OpenGammaProject/Enhanced-Geiger/Hardware/BOM.csv

ID | Name | Designator | Footprint | Quantity | Manufacturer Part | Manufacturer | Supplier | Supplier Part | Price
1 | SZYY1206YG | ACTIVITY | LED1206-R-RD_GREEN | 1 | SZYY1206YG | yongyu(永裕光电) | LCSC | C434442 | 0.016
2 | SMD-7525-3627-16Ω | BUZZER1 | BUZ-SMD_4P-L7.5-W7.5-BR | 1 | SMD-7525-3627-16Ω | S&S(海旭) | LCSC | C2685546 | 0.272
3 | 4.7uF | C1,C2,C7,C9,C11 | C0805 | 5 | CL21A475KBQNNNE | SAMSUNG(三星) | LCSC | C98192 | 0.023
4 | 10uF | C3,C5,C6,C8,C10 | C0603 | 5 | CL10A106MQ8NNNC | SAMSUNG(三星) | LCSC | C1691 | 0.002
5 | 100nF | C4 | C0603 | 1 | CL10B104KB8NNNC | SAMSUNG(三星) | LCSC | C1591 | 0.002
6 | 22pF | C12 | C0603 | 1 | GRM1882C1H220JA01D | muRata(村田) | LCSC | C85969 | 0.006
7 | BAT48ZFILM | D1,D2,D3 | SOD-123_L2.7-W1.6-LS3.7-RD-1 | 3 | BAT48ZFILM | ST(意法半导体) | LCSC | C2935154 | 0.108
8 | 0467.750NRHF | F1 | F0603 | 1 | 0467.750NRHF | Littelfuse(美国力特) | LCSC | C206991 | 0.048
9 | PH-2AW | H1,H3 | CONN-TH_PH-2AW | 2 | PH-2AW | CAX(创都) | LCSC | C722769 | 0.004
10 | TS-1103ST-C-B | KEY1 | KEY-SMD_4P-L12.0-W12.0-P5.00-LS15.1 | 1 | TS-1103ST-C-B | XKB Connectivity(中国星坤) | LCSC | C318913 | 0.051
11 | 22uH | L1 | IND-SMD_L3.0-W3.0_FNR30XXS | 1 | SLW3012S220MST | Sunltech(韩国顺磁) | LCSC | C206318 | 0.056
12 | 4.7uH | L2,L3 | L0603 | 2 | MLZ1608M4R7WT000 | TDK | LCSC | C76799 | 0.047
13 | DMG2305UX-13 | Q1 | SOT-23-3_L2.9-W1.3-P1.90-LS2.4-BR | 1 | DMG2305UX-13 | DIODES(美台) | LCSC | C144153 | 0.042
14 | 2N7002K_C414015 | Q2 | SOT-23-3_L2.9-W1.3-P1.90-LS2.4-BR | 1 | 2N7002K | MDD | LCSC | C414015 | 0.011
15 | 20kΩ | R1,R12 | RES-ADJ-TH_3362P | 2 | 3362P-1-203LF | BOURNS | LCSC | C81263 | 0.258
16 | 100Ω | R2,R5,R10,R16 | R0603 | 4 | 0603WAF1000T5E | UNI-ROYAL(厚声) | LCSC | C22775 | 0.001
17 | 1.8kΩ | R3,R6,R8,R11,R15,R20 | R0603 | 6 | RT0603DRD071K8L | YAGEO(国巨) | LCSC | C705955 | 0.013
18 | 499kΩ | R4,R7,R18,R21 | R0603 | 4 | TR0603B499KP0525Z | EVER OHMS(天二科技) | LCSC | C149937 | 0.015
19 | 10kΩ | R9 | R0603 | 1 | ARG03DTC1002 | Viking(光颉) | LCSC | C311889 | 0.007
20 | 22kΩ | R22 | R0603 | 1 | ARG03BTC2202 | Viking(光颉) | LCSC | C335085 | 0.024
21 | SK-3296S-01-L3 | SW1 | SW-SMD_SK-3296S-01-L3 | 1 | SK-3296S-01-L3 | XKB Connectivity(中国星坤) | LCSC | C319019 | 0.07
22 | TLV3201AIDBVR | U1 | SOT-23-5_L3.0-W1.7-P0.95-LS2.8-BR | 1 | TLV3201AIDBVR | TI(德州仪器) | LCSC | C105188 | 0.504
23 | LM4040AIM3-3.0+T | U2 | SOT-23-3_L2.9-W1.6-P1.90-LS2.8-BR | 1 | LM4040AIM3-3.0+T | ADI(亚德诺)/MAXIM(美信) | LCSC | C143326 | 1.087
24 | BQ21040DBVR | U3 | SOT-23-6_L2.9-W1.6-P0.95-LS2.8-BR | 1 | BQ21040DBVR | TI(德州仪器) | LCSC | C202311 | 0.336
25 | PI-PICO-SMD | U4 | RASPBERRY PICO SMD | 1 | PICO | Raspberry Pi | LCSC | C7203002 | 4.375
26 | AP3015KTR-G1 | U5 | SOT-23-5_L3.0-W1.7-P0.95-LS2.8-BR | 1 | AP3015KTR-G1 | DIODES(美台) | LCSC | C151334 | 0.22
