OpenGammaProject/Enhanced-Geiger/Hardware/schematic.pdf

# Pulse Discriminator

## Protected LiPo only!!!

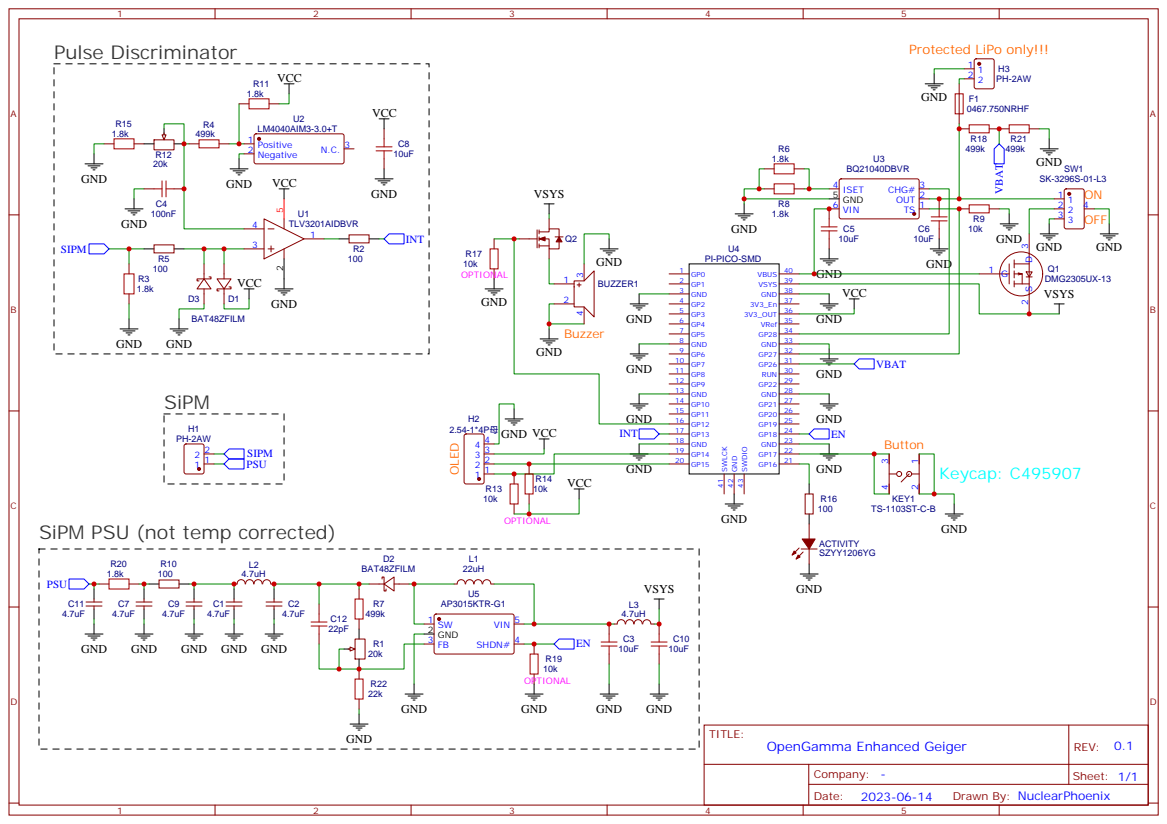
[picture p3: page 1]

SiPM PSU (not temp corrected)
