OpenGammaProject/Enhanced-Geiger/Software/enhanced_geiger/gfx.h

/*

  Contains graphics

*/

// Array of all bitmaps for convenience. (Total bytes used to store images in PROGMEM = 992)
// opengamma_pcb, 30 , 30 px
const uint8_t opengamma_pcb[] PROGMEM = {
  0x00, 0x00, 0x00, 0x00,
  0x00, 0x00, 0x00, 0x00,
  0x00, 0x03, 0x00, 0x00,
  0x00, 0x03, 0x00, 0x00,
  0x00, 0x07, 0x80, 0x00,
  0x00, 0x0c, 0xc0, 0x00,
  0x00, 0x0c, 0xc0, 0x00,
  0x00, 0x18, 0x60, 0x00,
  0x00, 0x18, 0x60, 0x00,
  0x00, 0x30, 0x30, 0x00,
  0x00, 0x30, 0x30, 0x00,
  0x00, 0x60, 0x18, 0x00,
  0x00, 0xc0, 0x0c, 0x00,
  0x00, 0xd8, 0x6c, 0x00,
  0x01, 0x9c, 0x66, 0x00,
  0x01, 0x84, 0x66, 0x00,
  0x03, 0x00, 0x43, 0x00,
  0x03, 0x02, 0x83, 0x00,
  0x06, 0x02, 0x81, 0x80,
  0x0c, 0x00, 0x00, 0xc0,
  0x0c, 0x01, 0x00, 0xc0,
  0x18, 0x01, 0x00, 0x60,
  0x18, 0x03, 0x00, 0x60,
  0x30, 0x03, 0x00, 0x30,
  0x20, 0x03, 0x00, 0x10,
  0x60, 0x03, 0x00, 0x18,
  0xc0, 0x00, 0x00, 0x0c,
  0xff, 0xff, 0xff, 0xfc,
  0x00, 0x00, 0x00, 0x00,
  0x00, 0x00, 0x00, 0x00
};

// nuclearphnx_pcb, 30 , 30 px
const uint8_t nuclearphnx_pcb[] PROGMEM = {
  0x00, 0x00, 0x00, 0x00,
  0x00, 0x00, 0x00, 0x00,
  0x00, 0x00, 0x00, 0x00,
  0x00, 0x02, 0x00, 0x00,
  0x00, 0x03, 0x00, 0x00,
  0x00, 0x07, 0x80, 0x00,
  0x00, 0x0d, 0xc0, 0x00,
  0x00, 0x6c, 0xdc, 0x00,
  0x00, 0xec, 0xfc, 0x00,
  0x00, 0xec, 0x3c, 0x00,
  0x01, 0xf8, 0x78, 0x00,
  0x01, 0xfc, 0x70, 0x00,
  0x00, 0xfe, 0x70, 0x00,
  0x00, 0xff, 0xf4, 0x00,
  0x00, 0xbf, 0xec, 0x00,
  0x01, 0xff, 0xcc, 0x00,
  0x03, 0xbf, 0xc6, 0x00,
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
  0xd9,
  0x80,
  0x30,
  0x00
};

// temperature-arrow-down-solid, 10 , 10 px
const uint8_t temperature_arrow_down_solid[] PROGMEM = {
  0x70,
  0x00,
  0x59,
  0x80,
  0x49,
  0x80,
  0x49,
  0x80,
  0x49,
  0x80,
  0x49,
  0x80,
  0xbd,
  0x80,
  0xbf,
  0xc0,
  0xd9,
  0x80,
  0x70,
  0x00
};
